LM13700/LDO-noise-amplifier/README.md

# LDO noise amplifier
LDO noise amplifier circuit for noise measurement. Project for AUPSC course 2022<br />
[Documentation](Documentation.pdf) file contains project documentation in Polish.
