LM13700/LDO-noise-amplifier/Amp.asc

R1: res; 10
R2: res; 1k
R3: res; 10
R4: res; 120
U3: UniversalOpAmp
U4: UniversalOpAmp
V1: voltage; 5
V2: voltage; 1µ
Named nets: 0, IN, VCC
.tran 1
