LM13700/LDO-noise-amplifier/LDO_noise.asc

C1: cap; 1µ; V=16 Irms=0 Rser=0.0237 Lser=872p mfg="Würth Elektronik" pn="885382207001 WCAP-CSST 0805" type="X7R"
R1: res; 330
U1: ADP121-3.3
V1: voltage; 5
Named nets: 0, LDO_OUT
.noise V(LDO_OUT) V1 dec 100 10 100k
